roc-ket-cod-er/CustomDevBoard/README.md

# pmDEV 2

pmDEV 2 is an all-in-one devboard that has every feature you could want included!

- [x] Wifi
- [x] microSD
- [x] 4-cores
- [x] 2 seperate CPUs (ESP32 & RP2350B)
- [x] Individualized USB
- [x] Upto 67 GPIO
- [x] Upto 18 + 8x 12-bit 3.3V ADCs
- [x] INA226
- [x] Built-in battery holders
- [x] High-power screw-terminals for easy battery access
- [x] 4x logic level converters
- [x] 2x low power signal amplifiers
- [x] 1x 5A signal amplifier
- [x] GPS
- [x] RTC
- [x] IMU
- [x] Battery charging
- [x] 2x Screens (0.96" OLED, 3.5" LCD)

And much more, but you probably get the idea

Basically, you get as many features possible all crammed into a 100x100mm PCB, with a case to protect the sensitive electronics side from too much damage

















I set off to build this devboard simply because I was tired of questioning whether it was the fault of the software or hardware. With the entire PCB pre-made and tested, we can remove hardware from the list of uncertanities. I also always wanted to make a battery-power GPS, so this can work for this, but if I get board of the GPS, it can always be reperposed for almost any task, especiall with those 60+ availible GPIOs.

## BOM
<sub> *Shipping not included </sub>

| Item | Cost (approx) | Link |
| - | - | - |
| PCBA (2pcs) | $155.80  | jlcpcb.com |
| Case | $ 24.19 | jlc3dp.com |
| CR2032 | $5.50 | https://www.canadiantire.ca/en/pdp/energizer-1-pk-cr2032-3v-3-volt-lithium-coin-cell-battery-long-lasting-0651016p.html |
