roc-ket-cod-er/CustomDevBoard/BOM - Sheet1.csv

Item | Cost (NATIVE) | Cost USD | Link | NOTE
1-pk CR2032 3V | $7.31 | ~$5.5 | https://www.canadiantire.ca/en/pdp/energizer-1-pk-cr2032-3v-3-volt-lithium-coin-cell-battery-long-lasting-0651016p.html
Case | $37.35 | $37.35 | https://jlc3dp.com/ | Would like to print myself if I acheive 18 points
PCB | $222.38 | $222.38 | https://jlcpcb.com/
TOTAL |  | $259.73
