roc-ket-cod-er/CustomDevBoard/PCB/BOM_Board1_PCB1_2025-07-15.csv

No. | Quantity | Comment | Designator | Footprint | Value | Manufacturer Part | Manufacturer | Supplier Part | Supplier
1 | 2 | BH-18650-A1AJ006 | BT1,BT2 | BAT-TH_BH-18650-A1AJ006 |  | BH-18650-A1AJ006 | MYOUNG(美阳) | C5290175 | LCSC
2 | 1 | CR2032弯脚电池片铜 3V | BT4 | BAT-SMD_CR2032-3V |  | CR2032弯脚电池片铜 3V | Q&J | C70373 | LCSC
3 | 11 | 10uF | C1,C5,C101,C123,C124,C203,C209,C217,C219,C221,C223 | C0402 | 10uF | CL05A106MQ5NUNC | SAMSUNG(三星) | C15525 | LCSC
4 | 26 | 100nF | C2,C8,C11,C12,C13,C14,C15,C16,C17,C18,C20,C21,C102,C201,C202,C204,C208,C210,C211,C218,C229,C230,C232,C233,C235,C238 | C0402 | 100nF | CL05B104KO5NNNC | SAMSUNG(三星) | C1525 | LCSC
5 | 3 | 15pF | C3,C4,C237 | C0402 | 15pF | 0402CG150J500NT | FH(风华) | C1548 | LCSC
6 | 5 | 4.7uF | C6,C7,C9,C10,C205 | C0402 | 4.7uF | CL05A475MP5NRNC | SAMSUNG(三星) | C23733 | LCSC
7 | 4 | 1uF | C206,C207,C212,C224 | C0402 | 1uF | CL05A105KA5NQNC | SAMSUNG(三星) | C52923 | LCSC
8 | 1 | 22pF | C213 | C0402 | 22pF | 0402CG220J500NT | FH(风华) | C1555 | LCSC
9 | 3 | 1nF | C214,C215,C216 | C0402 | 1nF | 0402B102K500NT | FH(风华) | C1523 | LCSC
10 | 5 | 10uF | C220,C222,C231,C234,C236 | C0603 | 10uF | CL10A106MA8NRNC | SAMSUNG(三星) | C96446 | LCSC
11 | 3 | 4.7uF | C225,C226,C227 | C0805 | 4.7uF | CL21A475KAQNNNE | SAMSUNG(三星) | C1779 | LCSC
12 | 1 | 330nF | C228 | C0603 | 330nF | 0603B334K250NT | FH(风华) | C1615 | LCSC
13 | 1 | TF PUSH | CARD1 | TF-SMD_TF-PUSH |  | TF PUSH | SHOU HAN(首韩) | C393941 | LCSC
14 | 4 | SS34 | D1,D6,D7,D8 | SMA_L4.3-W2.6-LS5.2-RD |  | SS34 | MDD(辰达半导体) | C8678 | LCSC
15 | 4 | ESD05V88D-LC | D2,D3,D4,D5 | DFN1006-2L-BI |  | ESD05V88D-LC | Leiditech(雷卯电子) | C5139330 | LCSC
16 | 1 | 2.54-1*4P母 | H1 | HDR-TH_4P-P2.54-V-F |  | 2.54-1*4P母 | BOOMELE(博穆精密) | C2718488 | LCSC
17 | 1 | PM2.54-1*10 | J1 | HDR-TH_10P-P2.54-V-F |  | PM2.54-1*10 | ZHOURI(洲日) | C5116489 | LCSC
18 | 3 | 2.54-2*20 | J2,J3,J4 | HDR-TH_40P-P2.54-V-F-R2-C20-S2.54 |  | 2.54-2*20 | ZHOURI(洲日) | C2977589 | LCSC
19 | 1 | 2.54-2*8P母 | J5 | HDR-TH_16P-P2.54-V-F-R2-C8-S2.54 |  | 2.54-2*8P母 | BOOMELE(博穆精密) | C30734 | LCSC
20 | 1 | AOTA-B201610S3R3-101-T | L1 | IND-SMD_L2.0-W1.6_AOTA-B201610S3R3-101-T |  | AOTA-B201610S3R3-101-T | ABRACON | C42411119 | LCSC
21 | 1 | 10uH | L2 | IND-SMD_L5.4-W5.2_FXL0530 | 10uH | FXL0530-100-M | cjiang(长江微电) | C177248 | LCSC
22 | 3 | KT-0805G | LED1,LED6,LED7 | LED0805-R-RD |  | KT-0805G | KENTO | C2297 | LCSC
23 | 3 | KT-0603R | LED2,LED3,LED4 | LED0603-RD |  | KT-0603R | KENTO | C2286 | LCSC
24 | 1 | KT-0805Y | LED5 | LED0805-R-RD |  | KT-0805Y | KENTO | C2296 | LCSC
25 | 2 | WJ500V-5.08-3P | P2,P3 | CONN-TH_3P-P5.00_WJ500V-5.08-3P |  | WJ500V-5.08-3P | KANGNEX(康奈克斯电气) | C72334 | LCSC
26 | 6 | BSS138 | Q1,Q2,Q6,Q7,Q8,Q9 | SOT-23-3_L2.9-W1.6-P1.90-LS2.8-BR |  | BSS138 | onsemi(安森美) | C52895 | LCSC
27 | 2 | S8050-J3Y | Q3,Q4 | SOT-23-3_L3.0-W1.7-P0.95-LS2.9-BR |  | S8050-J3Y | MDD(辰达半导体) | C364312 | LCSC
28 | 1 | AO3401A | Q5 | SOT-23_L2.9-W1.3-P1.90-LS2.4-BR |  | AO3401A | AOS | C15127 | LCSC
29 | 3 | AO3400A | Q10,Q11,Q12 | SOT-23-3_L2.9-W1.3-P1.90-LS2.4-BR |  | AO3400A | AOS | C20917 | LCSC
30 | 14 | 10kΩ | R1,R212,R213,R214,R215,R216,R217,R218,R239,R249,R250,R251,R257,R258 | R0402 | 10kΩ | 0402WGF1002TCE | UNI-ROYAL(厚声) | C25744 | LCSC
31 | 7 | 1kΩ | R2,R4,R6,R231,R254,R255,R256 | R0402 | 1kΩ | 0402WGF1001TCE | UNI-ROYAL(厚声) | C11702 | LCSC
32 | 1 | 33Ω | R3 | R0402 | 33Ω | 0402WGF330JTCE | UNI-ROYAL(厚声) | C25105 | LCSC
33 | 2 | 27Ω | R7,R8 | R0402 | 27Ω | 0402WGF270JTCE | UNI-ROYAL(厚声) | C25100 | LCSC
34 | 2 | 12kΩ | R121,R122 | R0402 | 12kΩ | 0402WGF1202TCE | UNI-ROYAL(厚声) | C25752 | LCSC
35 | 5 | 5.1kΩ | R206,R207,R210,R211,R227 | R0402 | 5.1kΩ | 0402WGF5101TCE | UNI-ROYAL(厚声) | C25905 | LCSC
36 | 11 | 4.7kΩ | R219,R220,R221,R241,R242,R243,R244,R245,R246,R247,R248 | R0402 | 4.7kΩ | 0402WGF4701TCE | UNI-ROYAL(厚声) | C25900 | LCSC
37 | 3 | 470Ω | R222,R223,R224 | R0402 | 470Ω | 0402WGF4700TCE | UNI-ROYAL(厚声) | C25117 | LCSC
38 | 1 | 20mΩ | R225 | RES-SMD_L6.4-W3.2-R2512 | 20mΩ | RLP25FEGR020 | 大毅科技 | C393069 | LCSC
39 | 1 | 10Ω | R226 | R0402 | 10Ω | 0402WGF100JTCE | UNI-ROYAL(厚声) | C25077 | LCSC
40 | 1 | 49.9kΩ | R228 | R0402 | 49.9kΩ | 0402WGF4992TCE | UNI-ROYAL(厚声) | C25897 | LCSC
41 | 2 | 400mΩ | R229,R230 | R1206 | 400mΩ | RTT06R40JTP | RALEC(旺诠) | C159399 | LCSC
42 | 1 | 100mΩ | R232 | R1206 | 100mΩ | 1206W4F100LT5E | UNI-ROYAL(厚声) | C25334 | LCSC
43 | 1 | 3Ω | R233 | R0402 | 3Ω | 0402WGJ030JTCE | UNI-ROYAL(厚声) | C270411 | LCSC
44 | 4 | 220Ω | R234,R235,R238,R240 | R0603 | 220Ω | 0603WAF2200T5E | UNI-ROYAL(厚声) | C22962 | LCSC
45 | 1 | 2.7kΩ | R237 | R0805 | 2.7kΩ | 0805W8F2701T5E | UNI-ROYAL(厚声) | C17530 | LCSC
46 | 1 | 10kΩ | RN1 | RES-ARRAY-SMD_0402-8P-L2.0-W1.0-BL | 10kΩ | 4D02WGJ0103TCE | UNI-ROYAL(厚声) | C25725 | LCSC
47 | 5 | TS-1088-AR02016 | SW1,SW2,SW6,SW7,SW10 | SW-SMD_L3.9-W3.0-P4.45 |  | TS-1088-AR02016 | XUNPU(讯普) | C720477 | LCSC
48 | 4 | SS12D07VG4 087 | SW3,SW5,SW9,SW11 | SW-TH_SS12D07VG4 |  | SS12D07VG4 087 | SHOU HAN(首韩) | C2939726 | LCSC
49 | 2 | K3-1391B-51 | SW4,SW8 | SW-TH_K3-1391B-51 |  | K3-1391B-51 | 韩国韩荣 | C92656 | LCSC
50 | 1 | RP2350B | U1 | QFN-80_L10.0-W10.0-P0.40-TL-EP3.4 |  | RP2350B | Raspberry Pi(树莓派) | C42415655 | LCSC
51 | 1 | ESP32-WROOM-32D-N16 | U2 | WIFIM-SMD_39P-L25.5-W18.0-P1.27-BL |  | ESP32-WROOM-32D-N16 | ESPRESSIF(乐鑫) | C529578 | LCSC
52 | 1 | W25Q128JVSIQ | U3 | SOIC-8_L5.3-W5.3-P1.27-LS8.0-BL |  | W25Q128JVSIQ | WINBOND(华邦) | C97521 | LCSC
53 | 4 | NCP1117DT33RKG | U5,U7,U18,U19 | TO-252-2_L6.6-W6.1-P4.57-LS9.9-TL-CW |  | NCP1117DT33RKG | onsemi(安森美) | C88234 | LCSC
54 | 1 | ABM8-272-T3 | U6 | CRYSTAL-SMD_4P-L3.2-W2.5-BL |  | ABM8-272-T3 | ABRACON | C20625731 | LCSC
55 | 1 | INA226AIDGSR | U10 | MSOP-10_L3.0-W3.0-P0.50-LS5.0-BL |  | INA226AIDGSR | TI(德州仪器) | C49851 | LCSC
56 | 1 | L80RE-M37 | U12 | GPSM-SMD_12P-L16.0-W16.0-P2.54-BL |  | L80RE-M37 | Quectel(移远) | C3029061 | LCSC
57 | 1 | ICM-20948 | U13 | QFN-24_L3.0-W3.0-P0.40-BL-EP |  | ICM-20948 | TDK InvenSense(应美盛) | C726001 | LCSC
58 | 1 | SSP6206-18NR | U14 | SOT-23-3_L2.9-W1.3-P1.90-LS2.4-BR |  | SSP6206-18NR | Siproin(上海矽朋) | C277878 | LCSC
59 | 1 | CP2102-GMR | U15 | WQFN-28_L5.0-W5.0-P0.50-BL-EP3.2 |  | CP2102-GMR | SKYWORKS/SILICON LABS(芯科) | C6568 | LCSC
60 | 1 | L7812CD2T-TR | U17 | TO-263-2_L10.0-W9.1-P5.08-LS15.2-TL |  | L7812CD2T-TR | ST(意法半导体) | C13456 | LCSC
61 | 1 | HUSB238_002DD | U20 | DFN-10_L3.0-W3.0-P0.50-BL-EP2.5 |  | HUSB238_002DD | Hynetek(慧能泰) | C7471904 | LCSC
62 | 1 | TP5100 | U21 | TQFN-16_L4.0-W4.0-P0.65-BL-EP |  | TP5100 | TOPPOWER(南京拓微) | C379389 | LCSC
63 | 1 | DS3231SN#T&R | U22 | SOIC-16_L10.3-W7.5-P1.27-LS10.3-BL |  | DS3231SN#T&R | ADI(亚德诺)/MAXIM(美信) | C9866 | LCSC
64 | 3 | TYPE-C 16PIN 2MD(073) | USB1,USB2,USB3 | USB-C-SMD_TYPE-C-6PIN-2MD-073 |  | TYPE-C 16PIN 2MD(073) | SHOU HAN(首韩) | C2765186 | LCSC
