roc-ket-cod-er/CustomDevBoard/3D/CASE.obj

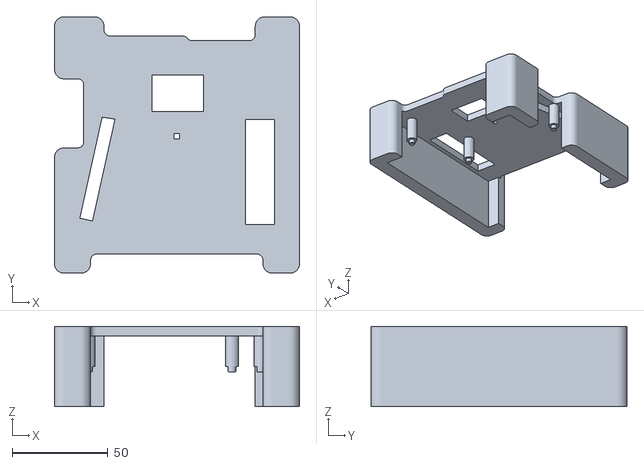
[picture p1: CAD file, 2025-07-15]
3D/CASE.obj
128.0 x 134.0 x 42.0
