roc-ket-cod-er/CustomDevBoard/PCB/SCH_Schematic1_2025-07-15.pdf

# POWER (USB)

# POWER (Inductor)

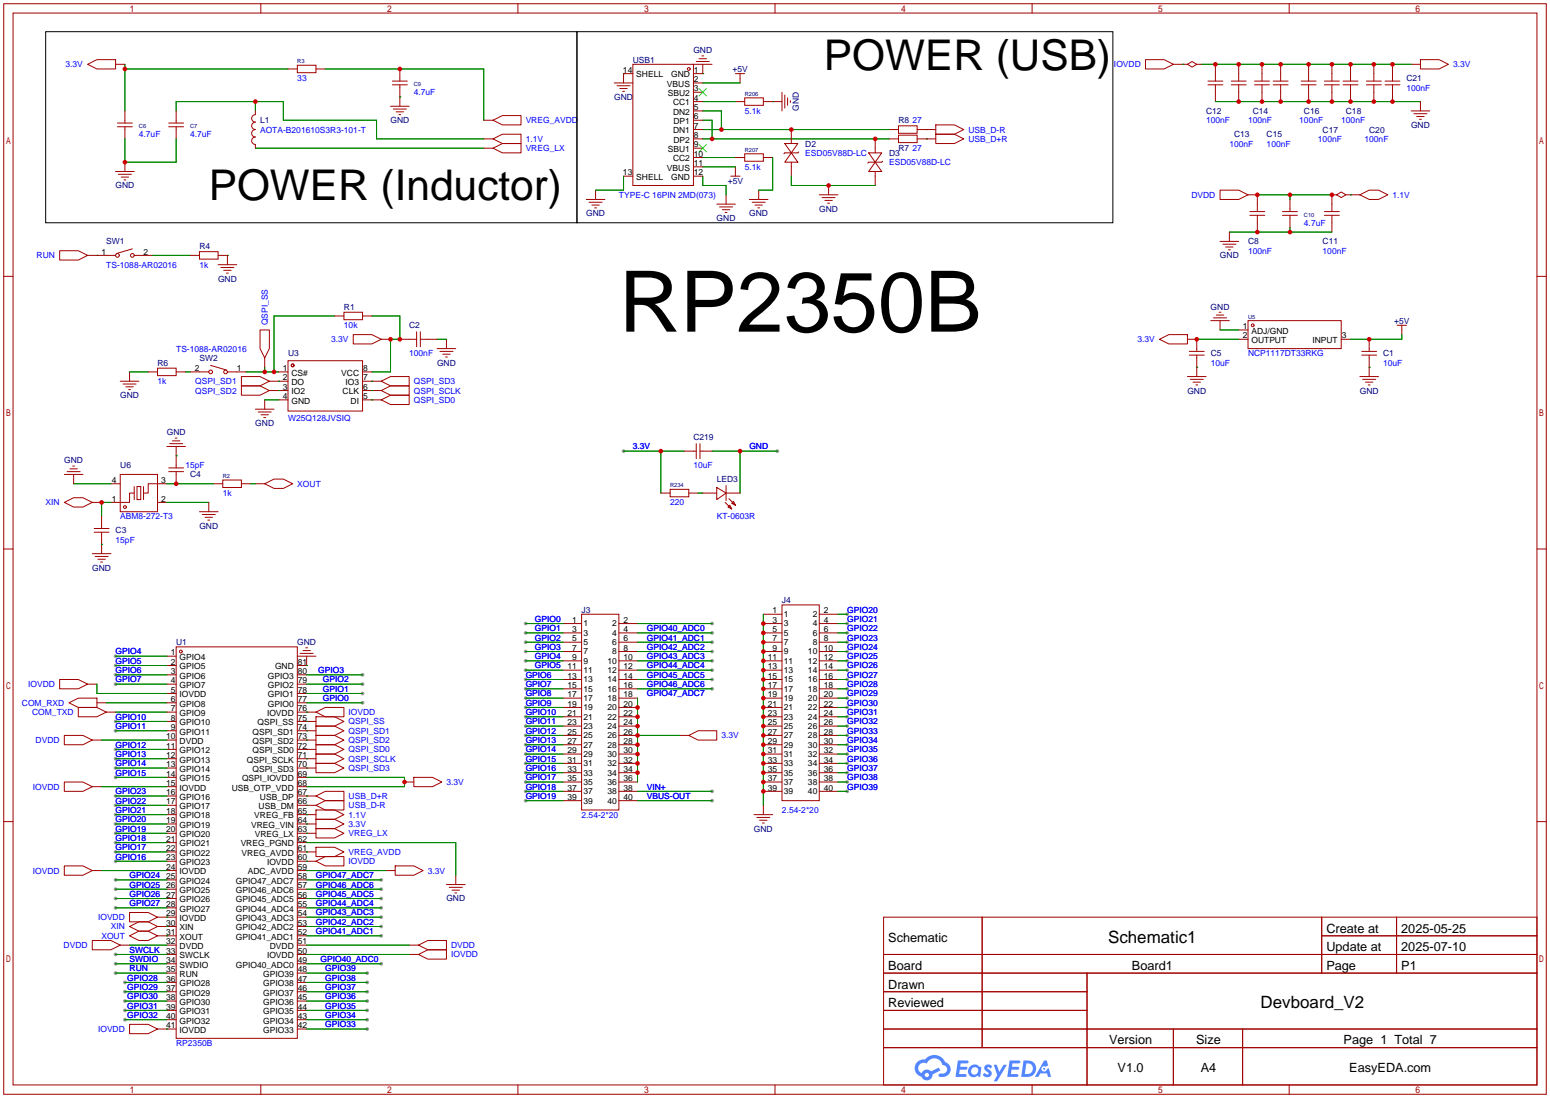
[picture p2: page 1]

Schematic | Schematic1 | Create at | 2025-05-25

Update at | 2025-07-10

Board | Board1 | Page | P1
Drawn | | Devboard_V2
Reviewed

Version | Size | Page 1 Total 7
V1.0 | A4 | EasyEDA.com

V1.0 | A4 | EasyEDA.com GND

# POWER (USB)

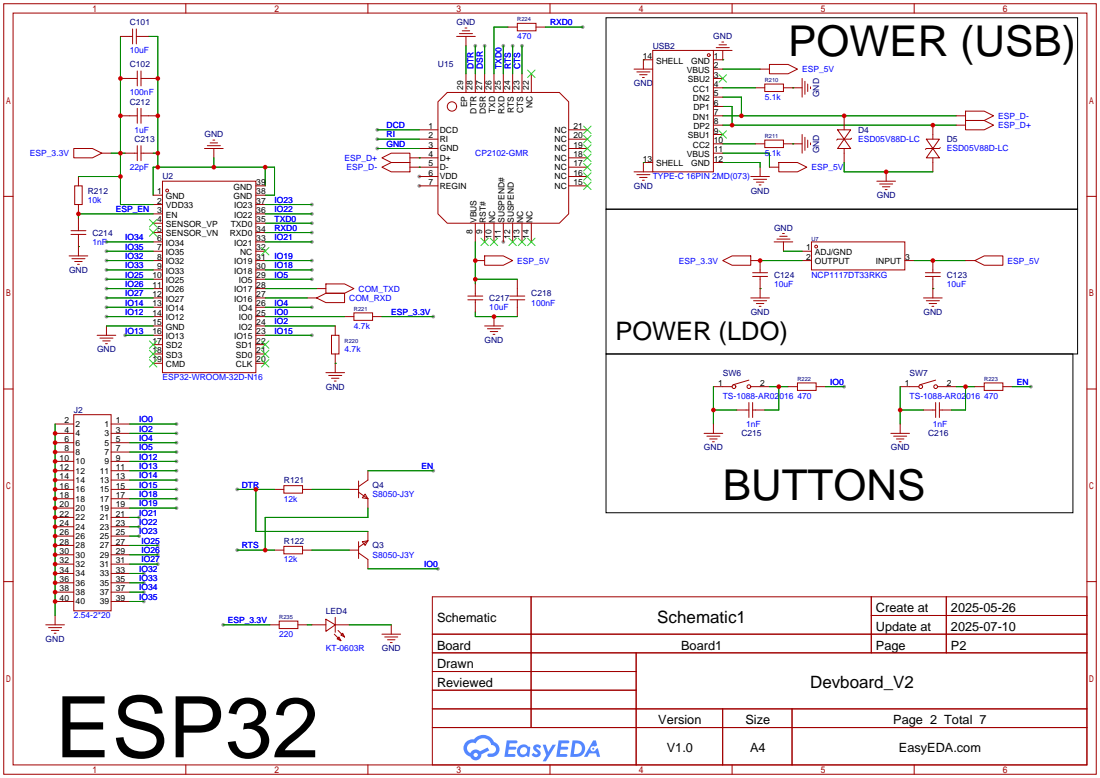
[picture p3: page 2]

GND

NC 22 CTS 23 RTS 24 RXD 25 TXD 26 DSR 27 DTR 28 EP 29

Schematic | Schematic1 | Create at | 2025-05-26

Update at | 2025-07-10

Board | Board1 | Page | P2
Drawn | | Devboard_V2
Reviewed

# BATTERY & INA

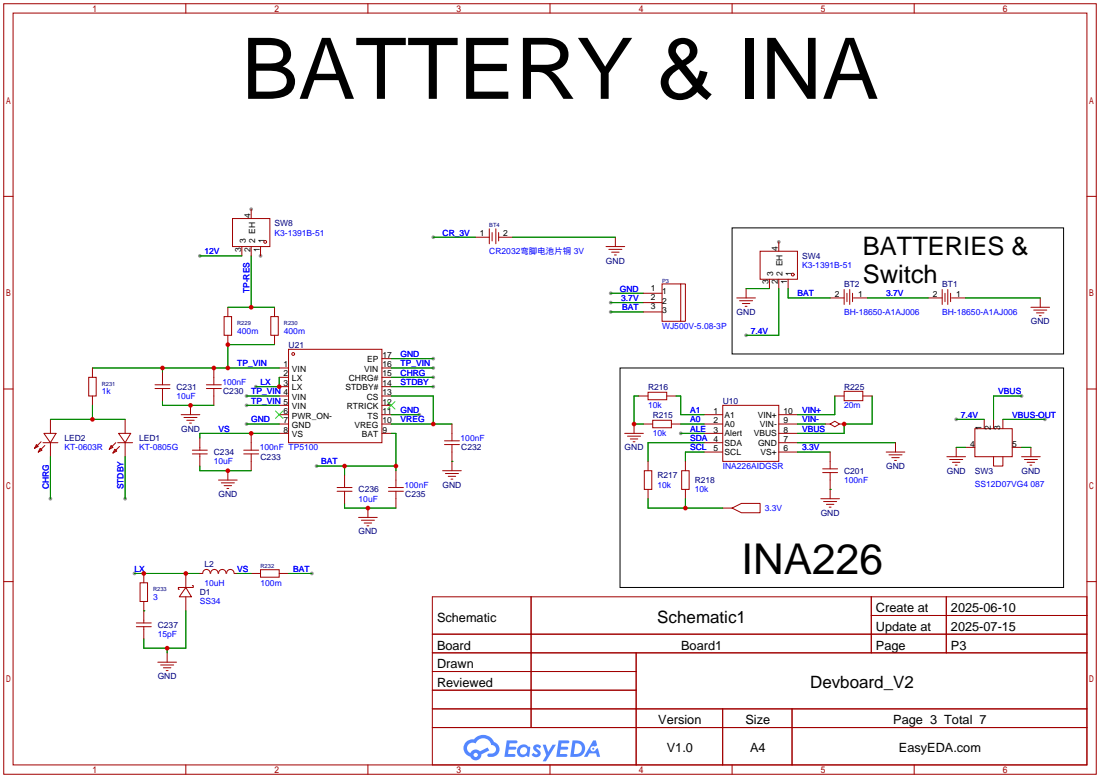
[picture p4: page 3]

VREG 10 TS 11 RTRICK 12 CS 13 STDBY# 14 CHRG# 15 VIN 16 EP 17

Schematic | Schematic1 | Create at | 2025-06-10

Update at | 2025-07-15

Board | Board1 | Page | P3
Drawn | | Devboard_V2
Reviewed

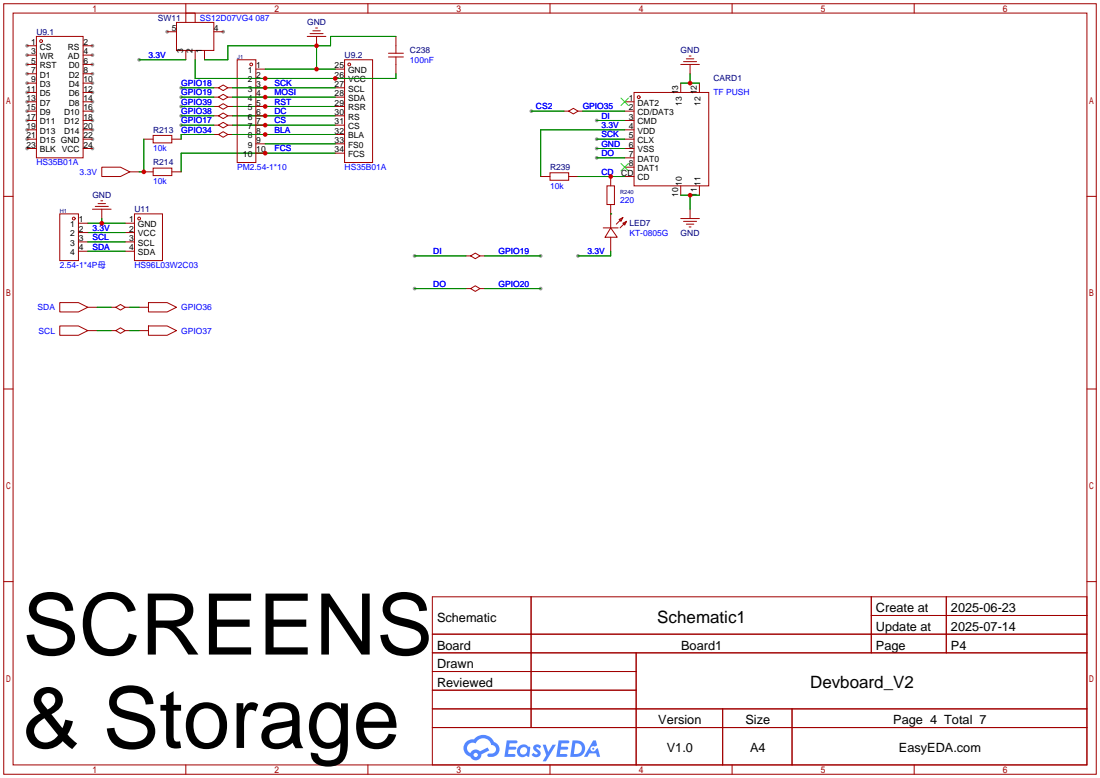
[picture p5: page 4]

Schematic | Schematic1 | Create at | 2025-06-23

Update at | 2025-07-14

Board | Board1 | Page | P4
Drawn | | Devboard_V2
Reviewed

# GPS & IMU

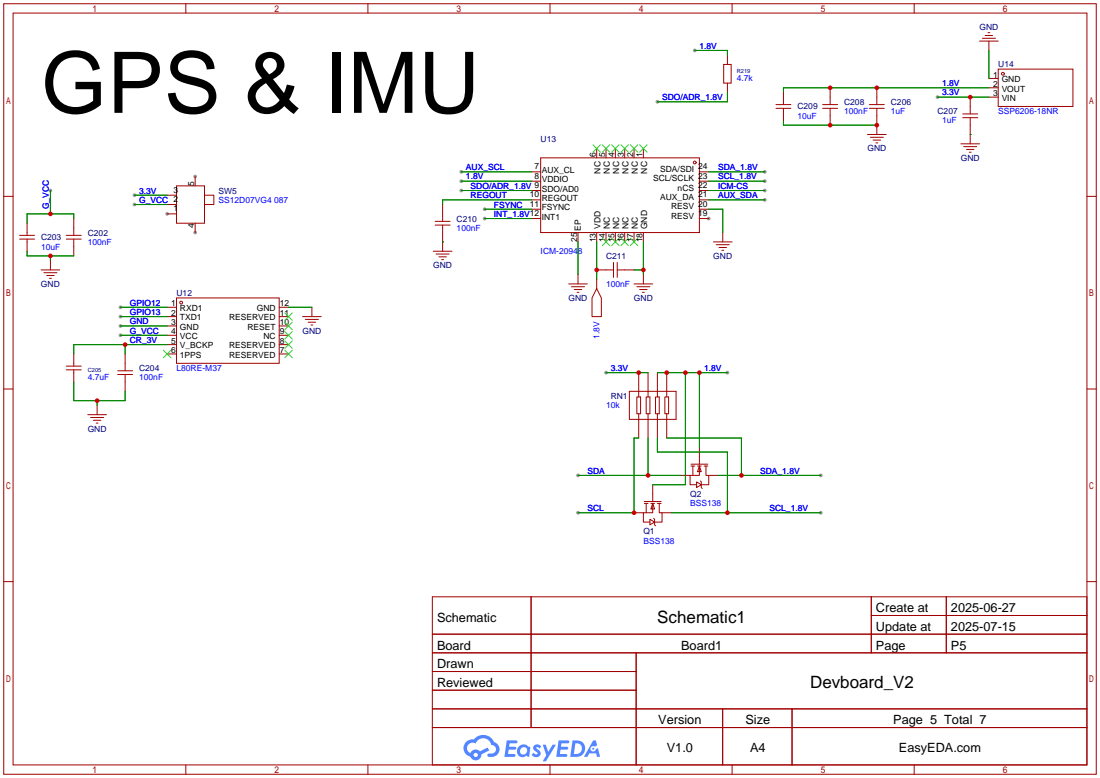
[picture p6: page 5]

Schematic | Schematic1 | Create at | 2025-06-27

Update at | 2025-07-15

Board | Board1 | Page | P5
Drawn | | Devboard_V2
Reviewed

# POWER RAILS

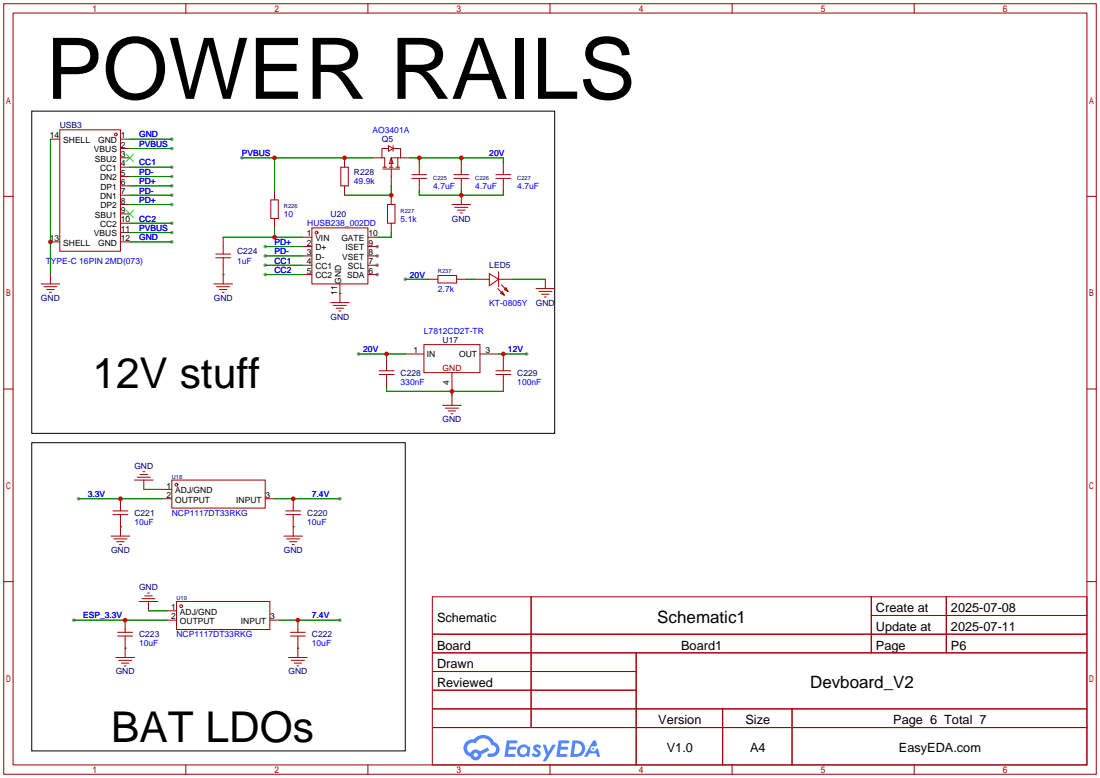
[picture p7: page 6]

Schematic | Schematic1 | Create at | 2025-07-08

Update at | 2025-07-11

Board | Board1 | Page | P6
Drawn | | Devboard_V2
Reviewed

USER & MISC.

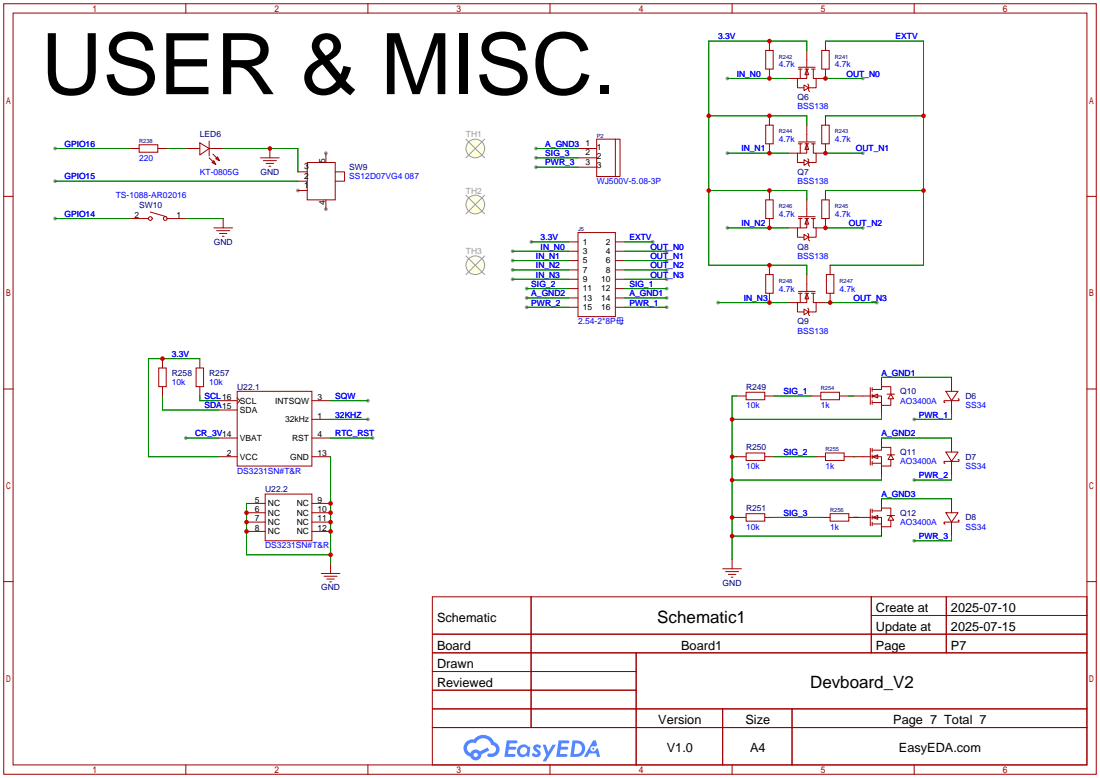
[picture p8: page 7]

Schematic | Schematic1 | Create at | 2025-07-10

Update at | 2025-07-15

Board | Board1 | Page | P7
Drawn | | Devboard_V2
Reviewed
