roc-ket-cod-er/CustomDevBoard/(list of files, drawings)

Other design files:
PCB/ProPrj_Devboard_V2_2025-07-15.epro
