roc-ket-cod-er/CustomDevBoard/(commit log)

2025-07-15 Update and rename CASE.obj to CASE.obj
    [CASE.obj]
2025-07-15 Update and rename BOM - Sheet1.csv to BOM.csv
    [BOM.csv]
